Self-Made-Keyboards-in-Japan/Casasagi/readme.md

# Casasagi
The mechanical keyboard made by SMKiJ community.

Work in progress

## components library
need to install SMKiJ components library.
https://github.com/Self-Made-Keyboards-in-Japan/SMKiJ_keyboard
