Self-Made-Keyboards-in-Japan/Casasagi/pcb/casasagi_right/casasagi_right.kicad_pcb

## KiCad design pcb/casasagi_right/casasagi_right.kicad_pcb (2021-05-04)

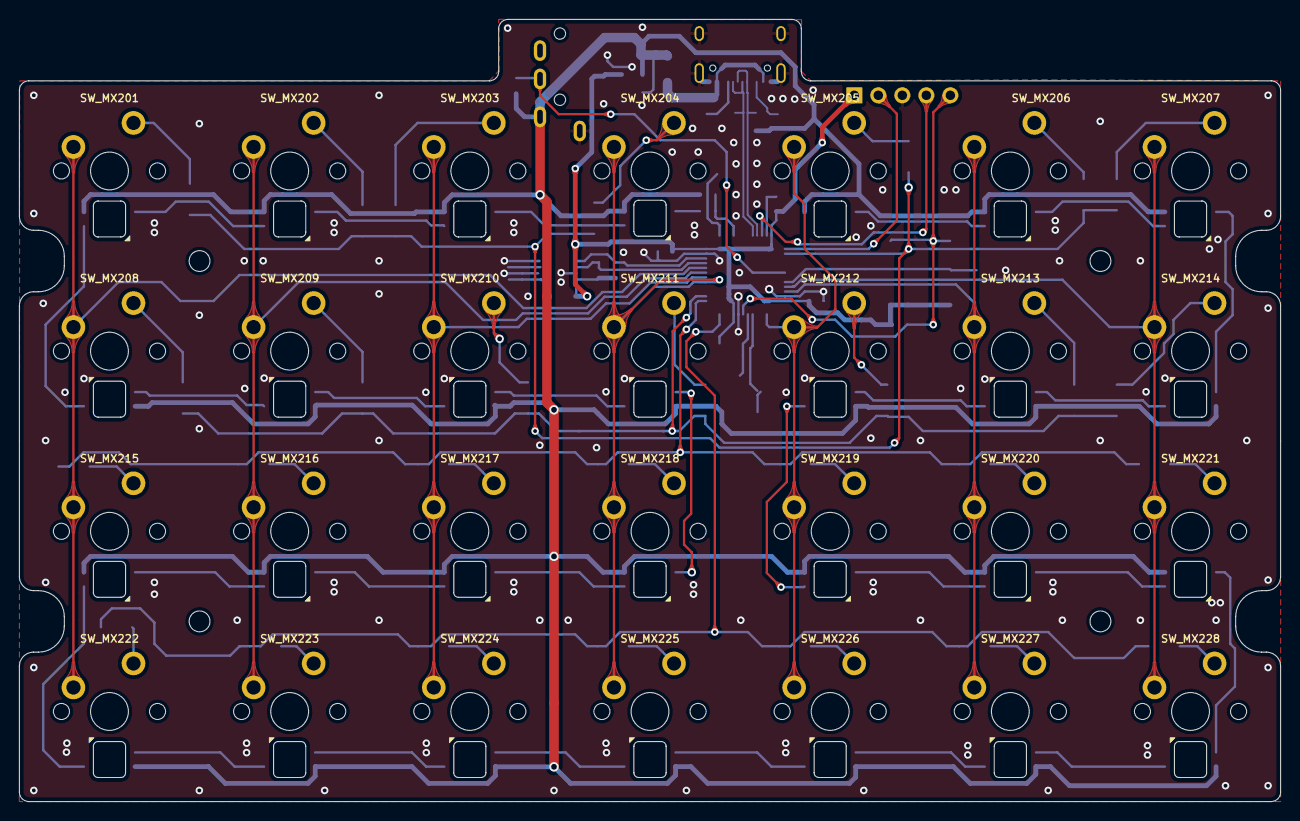
[picture p2: board casasagi_right.kicad_pcb from above]

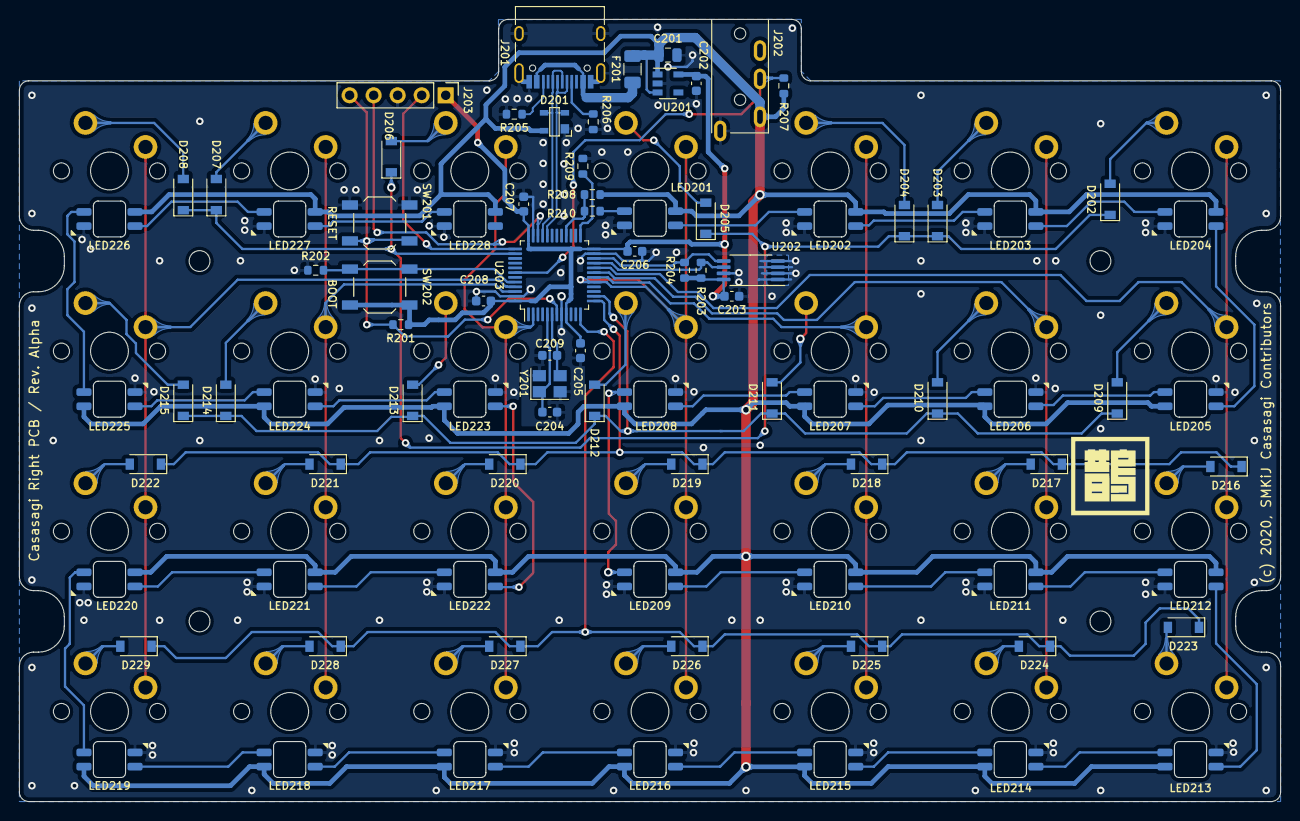
[picture p3: board casasagi_right.kicad_pcb from below]

Board: 2 copper layers, 133.3 x 82.7 mm, 119 parts (87 on the bottom side), 86 nets.

Parts:
C201: 10uF; C_0805_2012Metric
C202: 1uF; C_0603_1608Metric
C203, C205, C206, C207, C208: 0.1uF; C_0603_1608Metric
C204, C209: 22pF; C_0603_1608Metric
D201: PRTR5V0U2X; IC_SOT-143
D202, D203, D204, D205, D206, D207, D208, D209, D210, D211, D212, D213, D214, D215, D216, D217, D218, D219, D220, D221, D222, D223, D224, D225, D226, D227, D228, D229: 1N4148; D_SOD-123
F201: 1A; Fuse_1206_3216Metric
H1, H2, H3, H4: M2; MountingHole_2.2mm_M2
J201: USB_C_Receptacle_USB2.0; USB_C_Receptacle_HRO_TYPE-C-31-M-12
J202: AudioJack4; TRRS_MJ-4PP-9
J203: Conn_01x05; PinHeader_1x05_P2.54mm_Vertical
LED201, LED202, LED203, LED204, LED205, LED206, LED207, LED208, LED209, LED210, LED211, LED212, LED213, LED214, LED215, LED216, LED217, LED218, LED219, LED220, LED221, LED222, LED223, LED224, LED225, LED226, LED227, LED228: SK6812-MINI-E; LED_YS-SK6812MINI-E
LOGO1: casasagi_logo; logo
R201, R202, R203, R204, R205, R206, R207, R208, R209: 5.11k; R_0603_1608Metric
R210: 470R; R_0603_1608Metric
SW201: RESET; SW_SPST_TL3342
SW202: BOOT; SW_SPST_TL3342
SW_MX201, SW_MX202, SW_MX203, SW_MX204, SW_MX205, SW_MX206, SW_MX207, SW_MX208, SW_MX209, SW_MX210, SW_MX211, SW_MX212, SW_MX213, SW_MX214, SW_MX215, SW_MX216, SW_MX217, SW_MX218, SW_MX219, SW_MX220, SW_MX221, SW_MX222, SW_MX223, SW_MX224, SW_MX225, SW_MX226, SW_MX227, SW_MX228: SW_MX; SW_Cherry_MX_1.00u_PCB
U201: TLV73333PDBV; SOT-23-5
U202: AT24C256C-XHL-T; TSSOP-8_4.4x3mm_P0.65mm
U203: STM32F072C8Tx; LQFP-48_7x7mm_P0.5mm
Y201: 8MHz; Crystal_SMD_3225-4Pin_3.2x2.5mm

Connections:
+3V3: C202.2, C203.2, C205.2, C206.2, C207.2, C208.2, J203.1, R201.1, R203.1, R204.1, SW202.1, U201.5, U202.8, U203.9, U203.24, U203.36, U203.48
+5V: C201.2, D201.4, F201.1, J202.T, LED201.1, LED202.1, LED203.1, LED204.1, LED205.1, LED206.1, LED207.1, LED208.1, LED209.1, LED210.1, LED211.1, LED212.1, LED213.1, LED214.1, LED215.1, LED216.1, LED217.1, LED218.1, LED219.1, LED220.1, LED221.1, LED222.1, LED223.1, LED224.1, LED225.1, LED226.1, LED227.1, LED228.1, R207.1, R208.1, U201.1, U201.3
/COL0: SW_MX201.1, SW_MX208.1, SW_MX215.1, SW_MX222.1, U203.20
/COL1: SW_MX202.1, SW_MX209.1, SW_MX216.1, SW_MX223.1, U203.19
/COL2: SW_MX203.1, SW_MX210.1, SW_MX217.1, SW_MX224.1, U203.18
/COL3: SW_MX204.1, SW_MX211.1, SW_MX218.1, SW_MX225.1, U203.17
/COL4: SW_MX205.1, SW_MX212.1, SW_MX219.1, SW_MX226.1, U203.2
/COL5: SW_MX206.1, SW_MX213.1, SW_MX220.1, SW_MX227.1, U203.46
/COL6: SW_MX207.1, SW_MX214.1, SW_MX221.1, SW_MX228.1, U203.45
/I2C_SCL: R203.2, U202.6, U203.21
/I2C_SDA: R204.2, U202.5, U203.22
/LED: R208.2, R210.1, U203.28
/RESET: J203.5, R201.2, SW201.2, U203.7
/ROW0: D202.1, D203.1, D204.1, D205.1, D206.1, D207.1, D208.1, U203.38
/ROW1: D209.1, D210.1, D211.1, D212.1, D213.1, D214.1, D215.1, U203.14
/ROW2: D216.1, D217.1, D218.1, D219.1, D220.1, D221.1, D222.1, U203.13
/ROW3: D223.1, D224.1, D225.1, D226.1, D227.1, D228.1, D229.1, U203.12
/SPLIT_DATA: J202.R1, R207.2, U203.42
/SWCLK: J203.2, U203.37
/SWDIO: J203.4, U203.34
/USB_D+: D201.3, J201.A6, J201.B6, U203.33
/USB_D-: D201.2, J201.A7, J201.B7, U203.32
GND: C201.1, C202.1, C203.1, C204.2, C205.1, C206.1, C207.1, C208.1, C209.2, D201.1, J201.A1, J201.A12, J201.B1, J201.B12, J201.S1, J202.S, J203.3, LED201.3, LED202.3, LED203.3, LED204.3, LED205.3, LED206.3, LED207.3, LED208.3, LED209.3, LED210.3, LED211.3, LED212.3, LED213.3, LED214.3, LED215.3, LED216.3, LED217.3, LED218.3, LED219.3, LED220.3, LED221.3, LED222.3, LED223.3, LED224.3, LED225.3, LED226.3, LED227.3, LED228.3, R202.2, R205.2, R206.2, R209.2, SW201.1, U201.2, U202.1, U202.2, U202.3, U202.4, U202.7, U203.8, U203.23, U203.35, U203.47, Y201.2, Y201.4
unnamed: C204.1, U203.5, Y201.1
unnamed: C209.1, U203.6, Y201.3
unnamed: D202.2, SW_MX201.2
unnamed: D203.2, SW_MX202.2
unnamed: D204.2, SW_MX203.2
unnamed: D205.2, SW_MX204.2
unnamed: D206.2, SW_MX205.2
unnamed: D207.2, SW_MX206.2
unnamed: D208.2, SW_MX207.2
unnamed: D209.2, SW_MX208.2
unnamed: D210.2, SW_MX209.2
unnamed: D211.2, SW_MX210.2
unnamed: D212.2, SW_MX211.2
unnamed: D213.2, SW_MX212.2
unnamed: D214.2, SW_MX213.2
unnamed: D215.2, SW_MX214.2
unnamed: D216.2, SW_MX215.2
unnamed: D217.2, SW_MX216.2
unnamed: D218.2, SW_MX217.2
unnamed: D219.2, SW_MX218.2
unnamed: D220.2, SW_MX219.2
unnamed: D221.2, SW_MX220.2
unnamed: D222.2, SW_MX221.2
unnamed: D223.2, SW_MX222.2
unnamed: D224.2, SW_MX223.2
unnamed: D225.2, SW_MX224.2
unnamed: D226.2, SW_MX225.2
unnamed: D227.2, SW_MX226.2
unnamed: D228.2, SW_MX227.2
unnamed: D229.2, SW_MX228.2
unnamed: F201.2, J201.A4, J201.A9, J201.B4, J201.B9
unnamed: J201.A5, R206.1
unnamed: J201.B5, R205.1
unnamed: LED201.2, LED202.4
unnamed: LED201.4, R210.2
unnamed: LED202.2, LED203.4
unnamed: LED203.2, LED204.4
unnamed: LED204.2, LED205.4
unnamed: LED205.2, LED206.4
unnamed: LED206.2, LED207.4
unnamed: LED207.2, LED208.4
unnamed: LED208.2, LED209.4
unnamed: LED209.2, LED210.4
unnamed: LED210.2, LED211.4
unnamed: LED211.2, LED212.4
unnamed: LED212.2, LED213.4
unnamed: LED213.2, LED214.4
unnamed: LED214.2, LED215.4
unnamed: LED215.2, LED216.4
unnamed: LED216.2, LED217.4
unnamed: LED217.2, LED218.4
unnamed: LED218.2, LED219.4
unnamed: LED219.2, LED220.4
unnamed: LED220.2, LED221.4
unnamed: LED221.2, LED222.4
unnamed: LED222.2, LED223.4
unnamed: LED223.2, LED224.4
unnamed: LED224.2, LED225.4
unnamed: LED225.2, LED226.4
unnamed: LED226.2, LED227.4
unnamed: LED227.2, LED228.4
unnamed: R202.1, SW202.2, U203.44
unnamed: R209.1, U203.25
