Self-Made-Keyboards-in-Japan/Casasagi/(commit log)

2020-11-03 1st commit
    [casasagi_left.kicad_pcb, casasagi_left.sch]
2020-11-03 add info about kicad library
2020-11-03 change pcb outline
    [casasagi_left.kicad_pcb]
2020-11-05 replace stm32f072 symbol to kicad pre-installed one
    [casasagi_left.kicad_pcb, casasagi_left.sch]
2020-11-07 Increase cutout size to make keyboard assemblable
    [casasagi_left.kicad_pcb]
2020-11-07 move dimension to comment layer
    [casasagi_left.kicad_pcb]
2020-11-08 correct tab and connectors dimention
    [casasagi_left.kicad_pcb]
2020-11-25 make switch matrix simple
    [casasagi_left.kicad_pcb, casasagi_left.sch]
2020-11-26 add handness resistor
    [casasagi_left.kicad_pcb, casasagi_left.sch]
2020-12-01 adjust traces and silks
    [casasagi_left.kicad_pcb]
2020-12-01 add casasagi right pcb
    [casasagi_right.kicad_pcb, casasagi_right.sch]
2020-12-01 update reference number for panelization
    [casasagi_left.kicad_pcb, casasagi_left.sch, casasagi_right.kicad_pcb, casasagi_right.sch]
2020-12-01 add copyright on pcbs
    [casasagi_left.kicad_pcb, casasagi_right.kicad_pcb]
2020-12-02 add teardrops to right pcb
    [casasagi_right.kicad_pcb]
2020-12-02 add teardrop and adjust trace
    [casasagi_left.kicad_pcb, casasagi_right.kicad_pcb]
2020-12-02 fix directory name
    [casasagi_left.kicad_pcb, casasagi_left.sch, casasagi_right.kicad_pcb, casasagi_right.sch]
2020-12-02 add logo!!!!
    [casasagi_left.kicad_pcb, casasagi_left.sch, casasagi_right.kicad_pcb, casasagi_right.sch]
2020-12-03 add combined pcb
    [casasagi_left.kicad_pcb, casasagi_production.kicad_pcb, casasagi_right.kicad_pcb]
2020-12-03 add fiducial mark
    [casasagi_production.kicad_pcb]
2020-12-03 add schematic pdf
    [casasagi_left.sch, casasagi_right.sch]
2020-12-10 prepare pcb for BOM and add BOM left
    [BOM_casasagi_left.csv, casasagi_left.kicad_pcb, casasagi_left.sch, casasagi_production.kicad_pcb, casasagi_right.kicad_pcb, casasagi_right.sch]
2020-12-11 add right BOM
    [BOM_casasagi_right.csv]
2020-12-11 add production BOM
    [casasagi_production.csv]
2020-12-12 update mousebite
    [casasagi_production.kicad_pcb]
2021-04-25 add rev.alpha production pcb
    [bom_casasagi_production_jlc.csv, casasagi_production.csv, casasagi_production.kicad_pcb]
2021-05-02 Change boss thru hole to M2 thru hole
    Introduce M2 thru hole to fix switch plate and PCB together using M2 screw. Spacer style boss can be placed at the edge cutout.
    [casasagi_left.kicad_pcb, casasagi_production.kicad_pcb, casasagi_right.kicad_pcb]
2021-05-04 replace M2 holes to drill holes
    [casasagi_left.kicad_pcb, casasagi_left.sch, casasagi_production.kicad_pcb, casasagi_right.kicad_pcb, casasagi_right.sch]
